The-Mech-Minds/WRO26_Future-Engineers_TMM/others/README.md

# Current robot hardware

The current vehicle uses a Raspberry Pi 5, Raspberry Pi Build HAT, Hiwonder USB camera, LEGO steering and drive motors, and a Force Sensor connected to Build HAT port C. See the [five current vehicle views](../README.md#current-vehicle-photographs) for the actual assembly and [software overview](../README.md#software-structure) for the control flow.

Current robot hardware overview

The diagram shows the control connections documented for this build. The supplied `main.py` confirms the Force Sensor on port C; verify the motor port assignments against the configurable defaults in [`src/vehicle.py`](../src/vehicle.py) before wiring or driving.

The older Raspberry Pi 4B and Arduino pictures have been moved to [`archive/pi4-arduino/`](../archive/pi4-arduino/). They document an earlier prototype.
