The-Mech-Minds/WRO26_Future-Engineers_TMM/models/steering.jpg

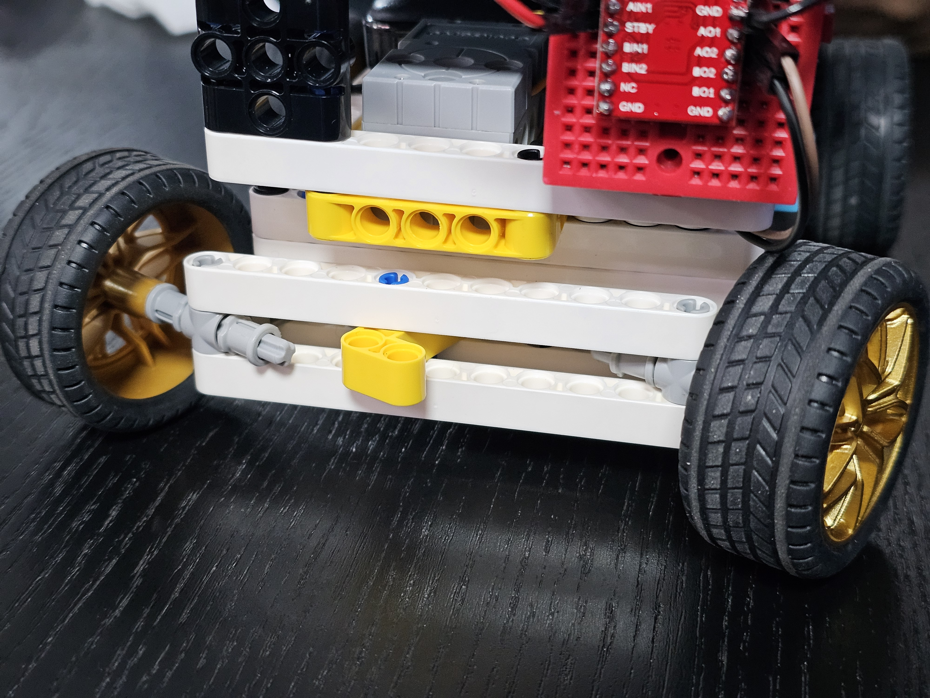
models/steering.jpg
