The-Mech-Minds/WRO26_Future-Engineers_TMM/others/7.4 V Battery Pack.jpg

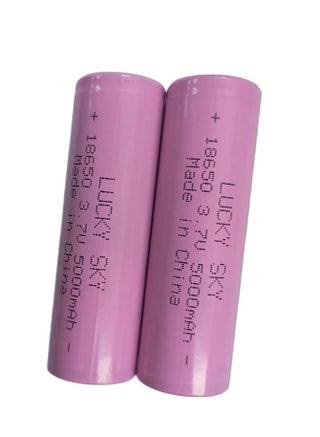
others/7.4 V Battery Pack.jpg
