The-Mech-Minds/WRO26_Future-Engineers_TMM/others/Arduino Uno.webp

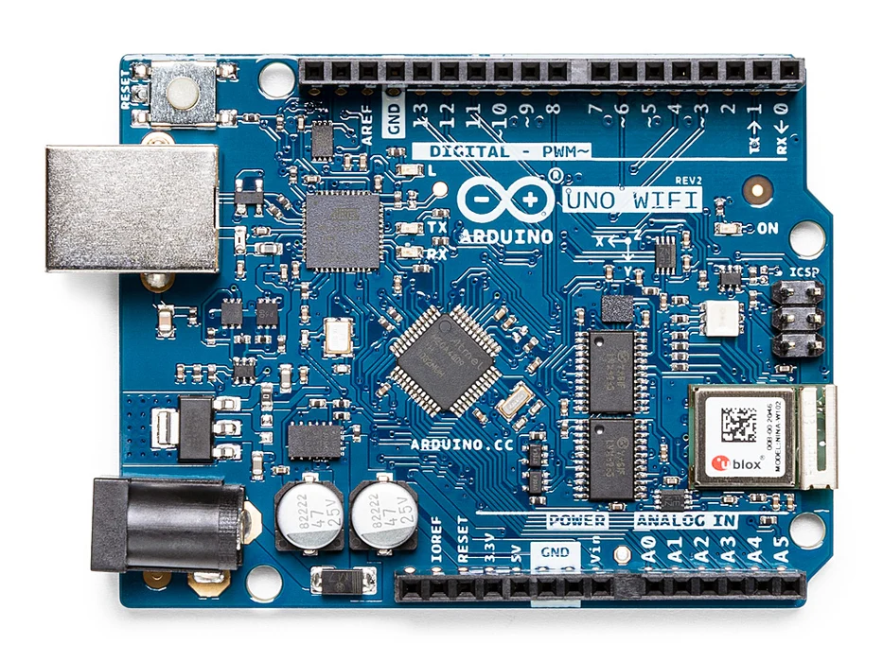
others/Arduino Uno.webp
