The-Mech-Minds/WRO26_Future-Engineers_TMM/others/camera view.jpeg

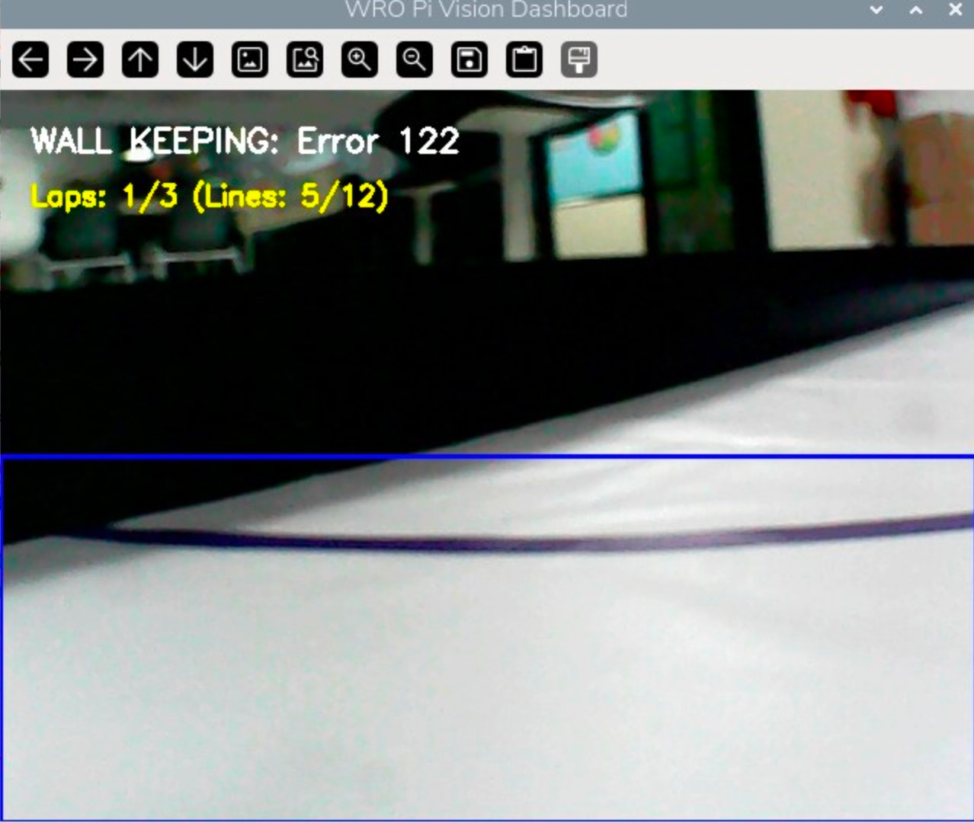
others/camera view.jpeg
