The-Mech-Minds/WRO26_Future-Engineers_TMM/others/Chassis and Drivetrain.jpeg

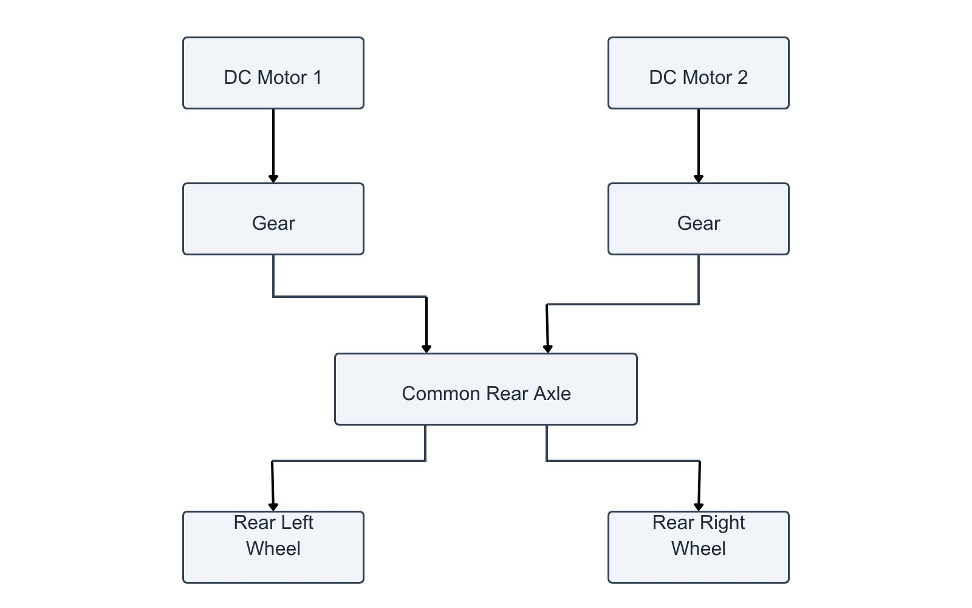
others/Chassis and Drivetrain.jpeg
