The-Mech-Minds/WRO26_Future-Engineers_TMM/others/DC Motors.jpg

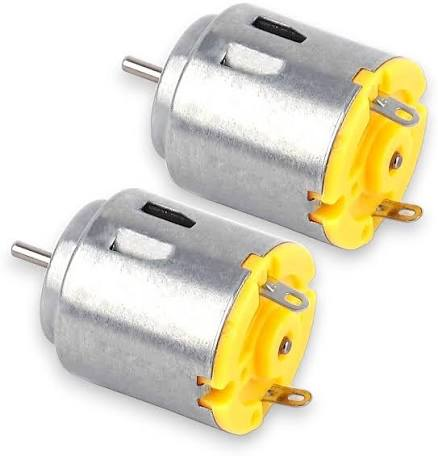
others/DC Motors.jpg
