The-Mech-Minds/WRO26_Future-Engineers_TMM/others/geekservo.webp

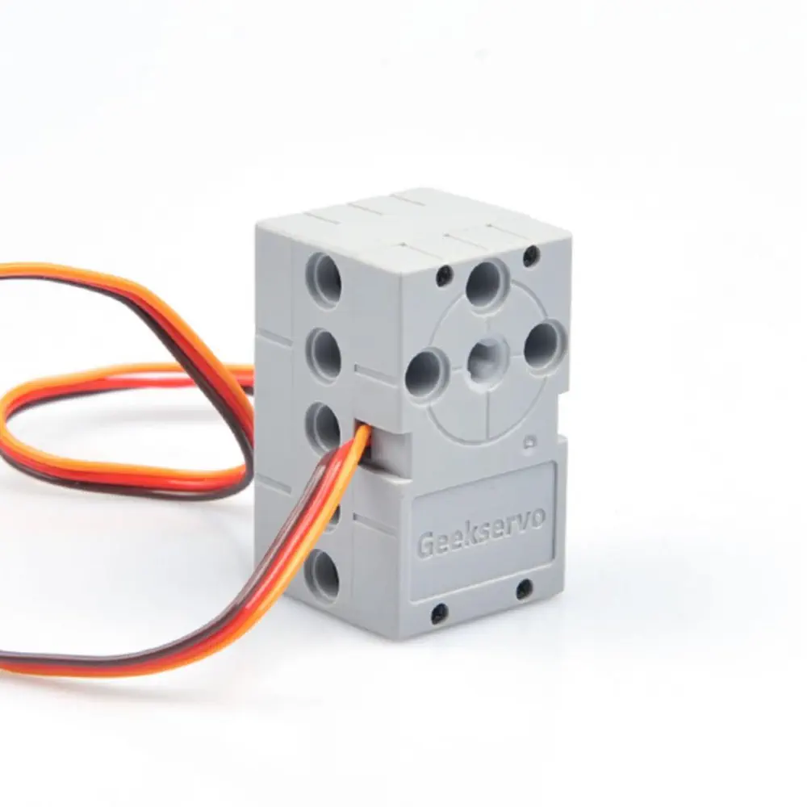
others/geekservo.webp
