The-Mech-Minds/WRO26_Future-Engineers_TMM/others/Motor + Servo.png

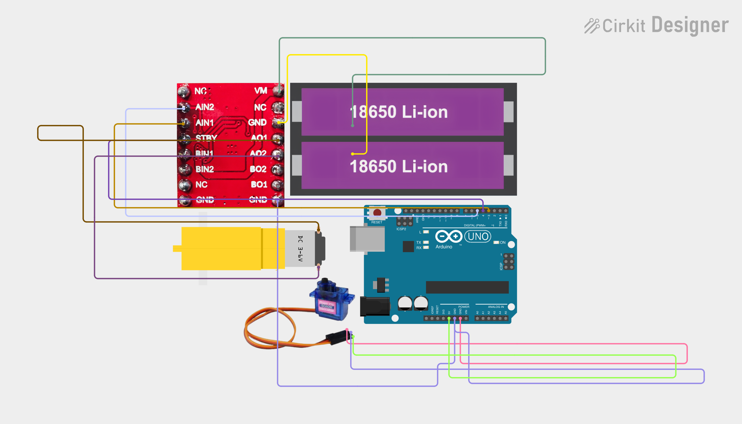
others/Motor + Servo.png
