The-Mech-Minds/WRO26_Future-Engineers_TMM/others/Pi + Arduino.png

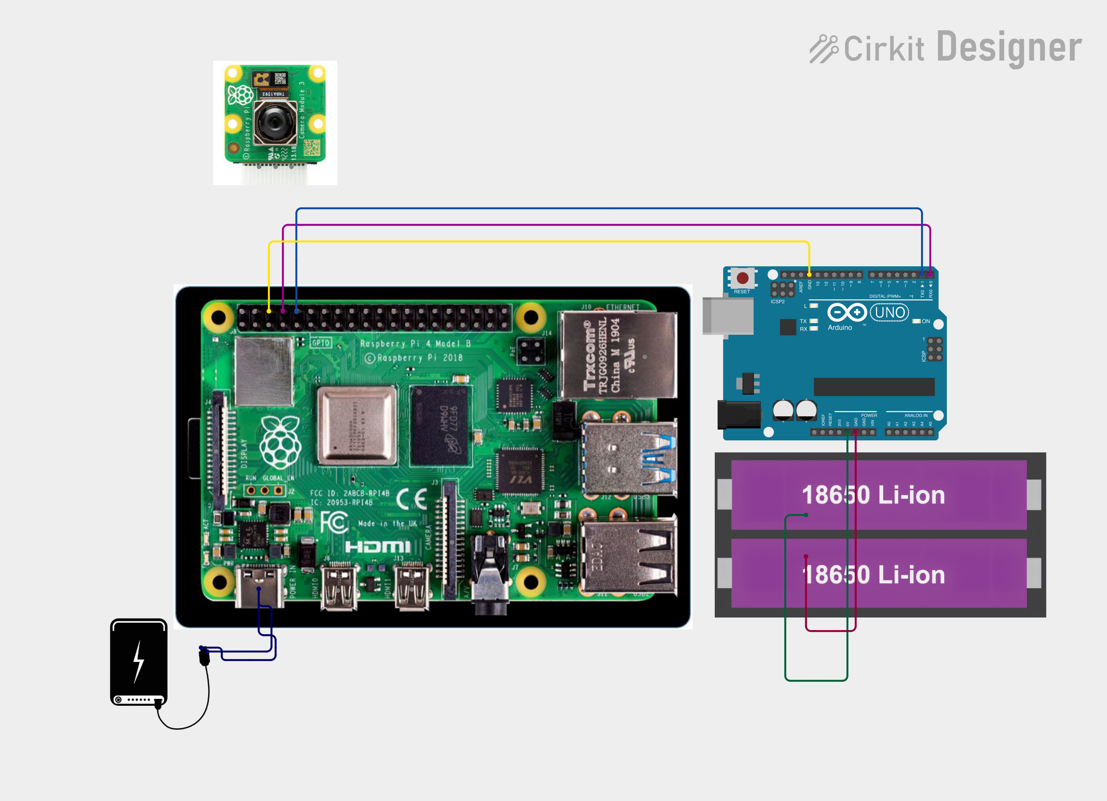
others/Pi + Arduino.png
