The-Mech-Minds/WRO26_Future-Engineers_TMM/others/Power Bank.webp

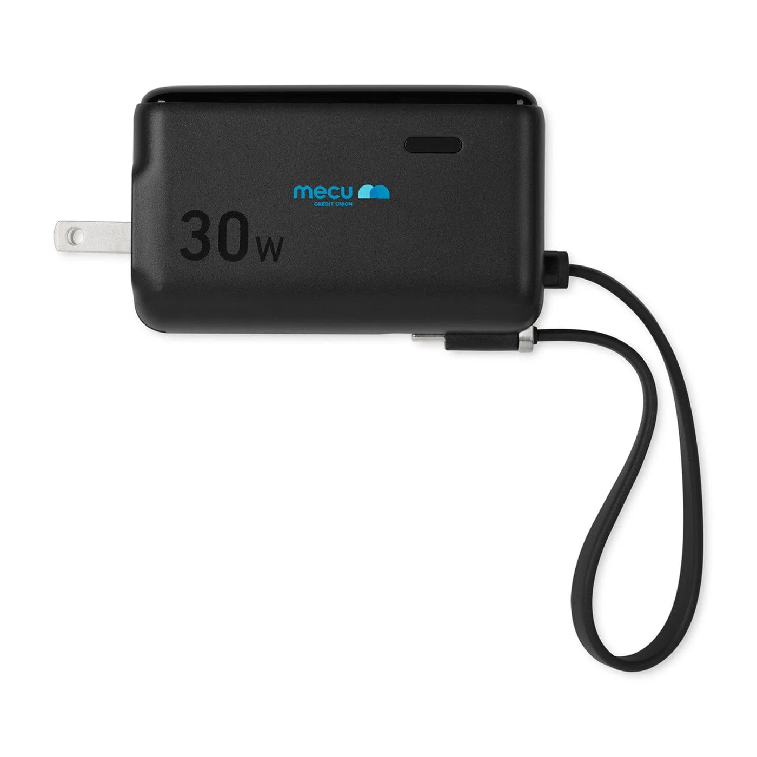
others/Power Bank.webp
