The-Mech-Minds/WRO26_Future-Engineers_TMM/others/power connection.jpeg

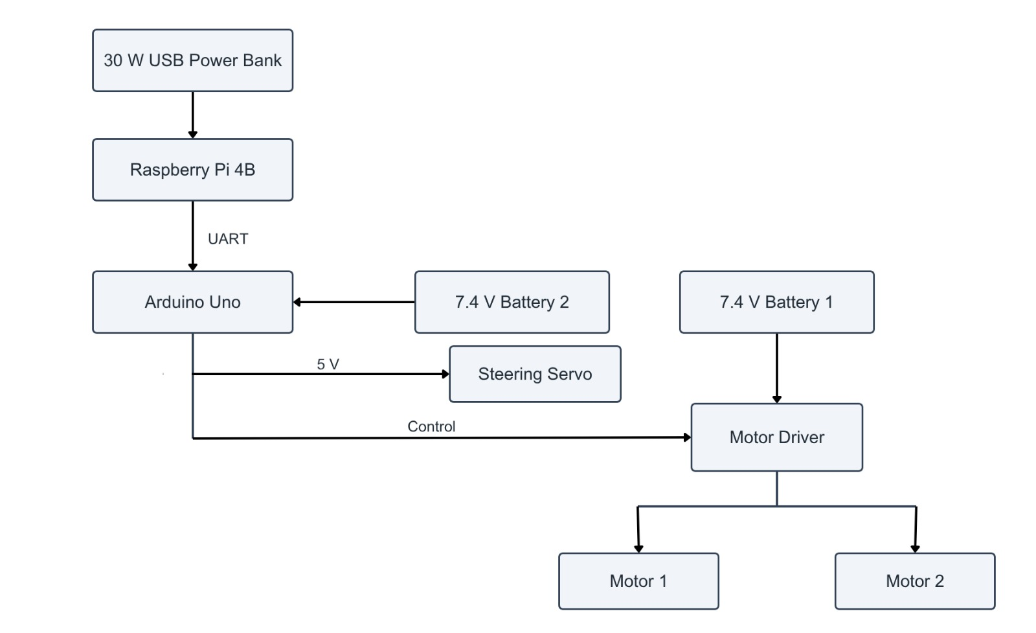
others/power connection.jpeg
