The-Mech-Minds/WRO26_Future-Engineers_TMM/others/Raspberry Pi 4B.webp

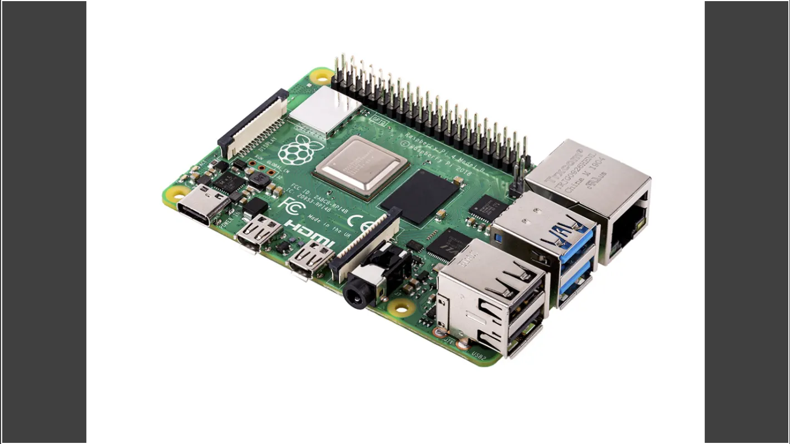
others/Raspberry Pi 4B.webp
