The-Mech-Minds/WRO26_Future-Engineers_TMM/others/Steering Servo.jpeg

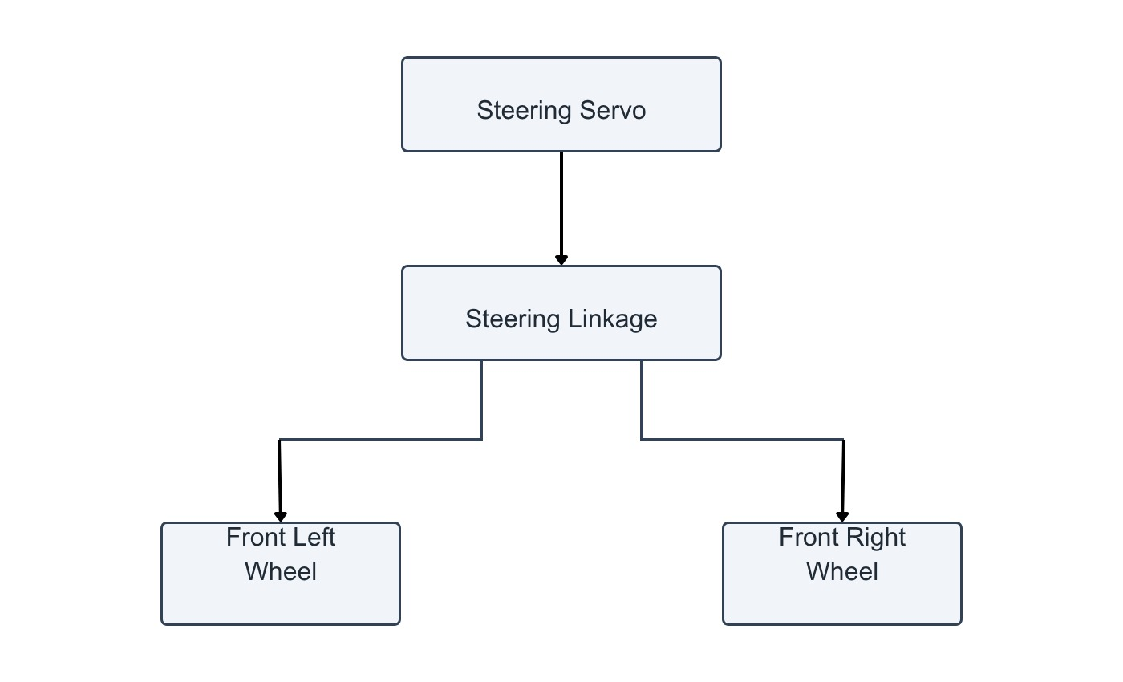
others/Steering Servo.jpeg
