The-Mech-Minds/WRO26_Future-Engineers_TMM/others/System Data Flow Diagram.jpeg

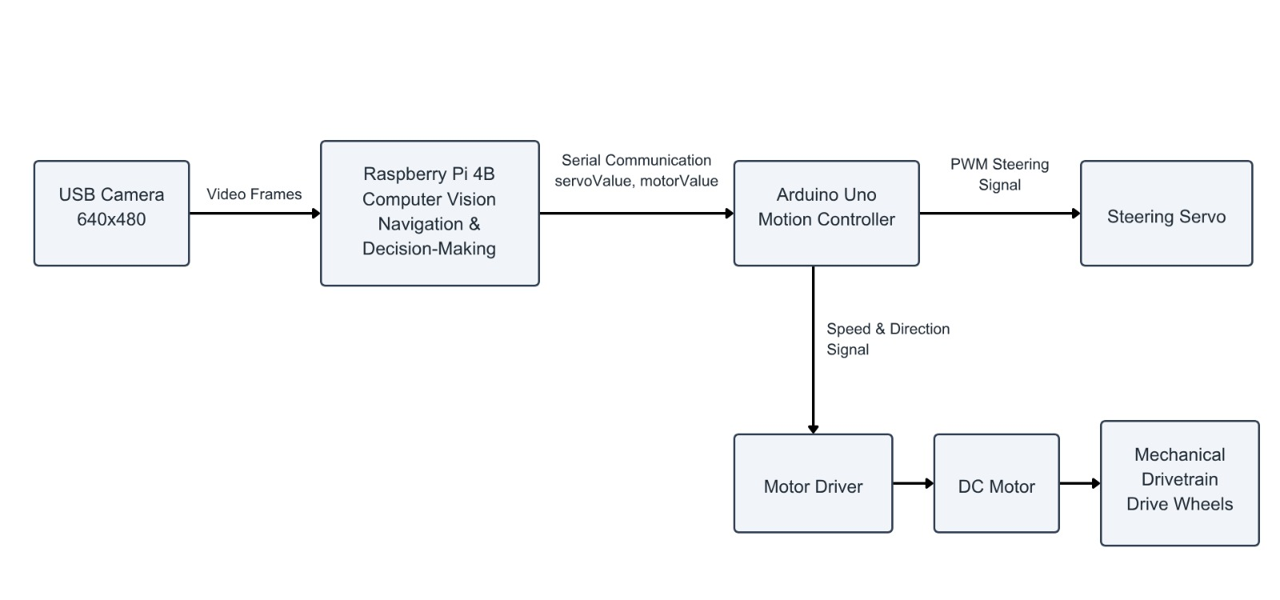
others/System Data Flow Diagram.jpeg
