The-Mech-Minds/WRO26_Future-Engineers_TMM/others/TB6612-type Dual DC Motor Driver.webp

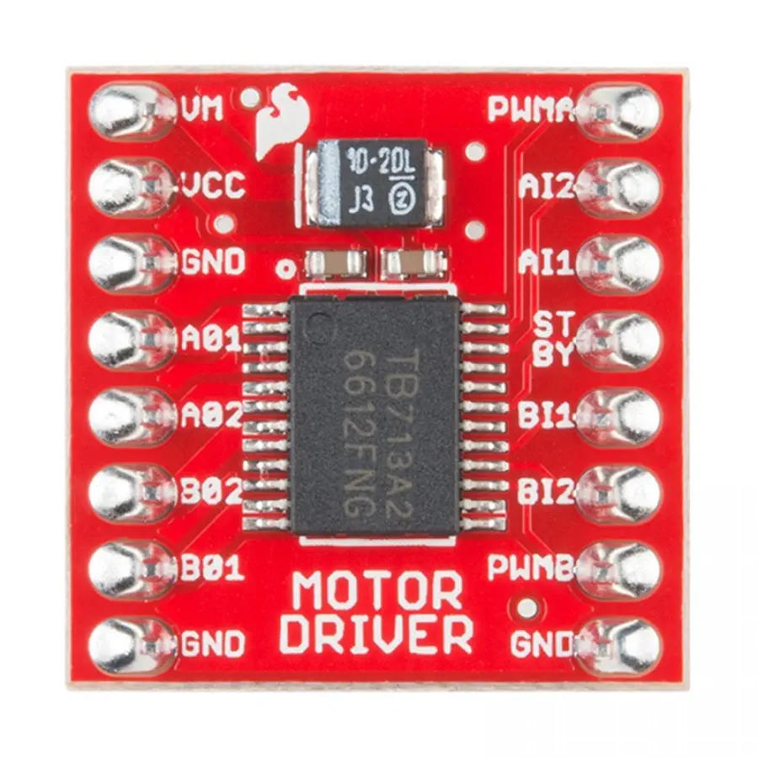
others/TB6612-type Dual DC Motor Driver.webp
