The-Mech-Minds/WRO26_Future-Engineers_TMM/others/USB Camera.jpg

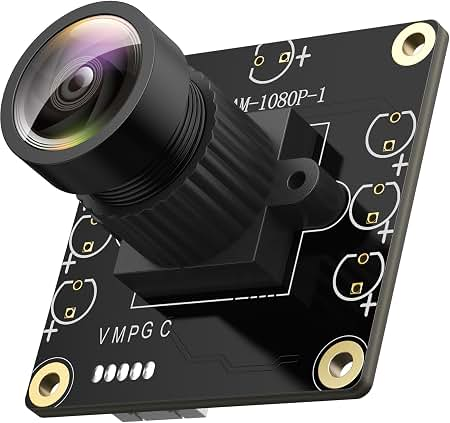
others/USB Camera.jpg
