The-Mech-Minds/WRO26_Future-Engineers_TMM/schemes/WhatsApp Image 2026-09-13 at 10.19.12.jpeg

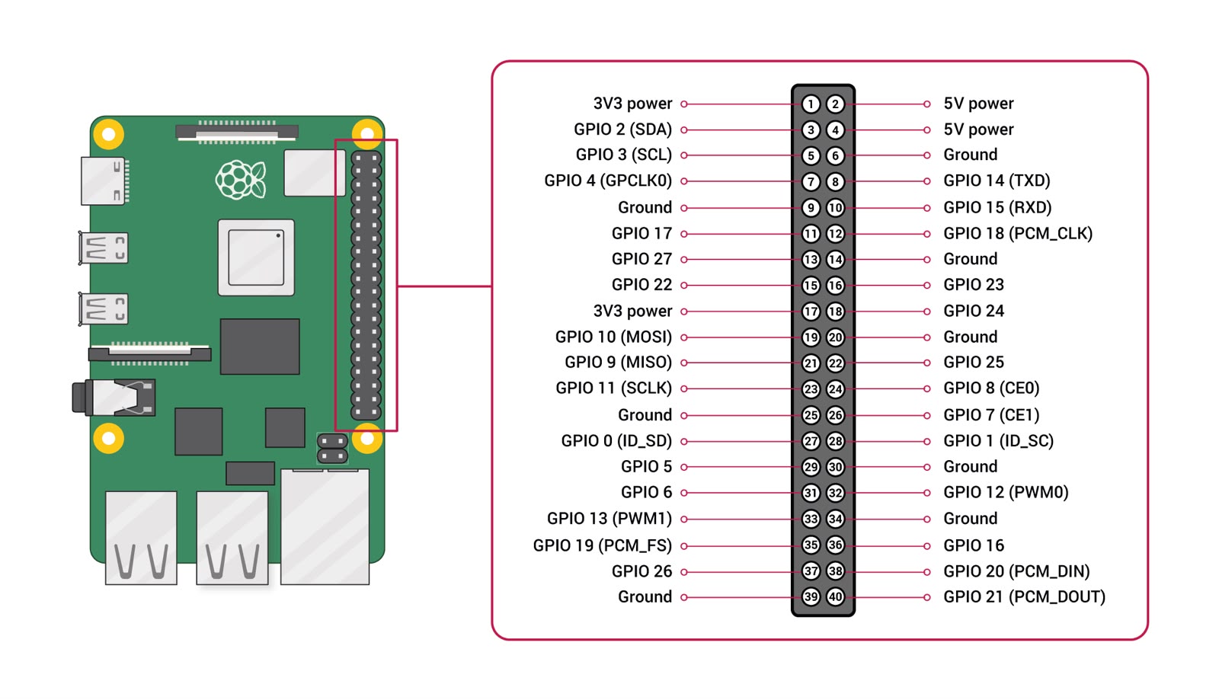
schemes/WhatsApp Image 2026-09-13 at 10.19.12.jpeg
