The-Mech-Minds/WRO26_Future-Engineers_TMM/t-photo/team.png

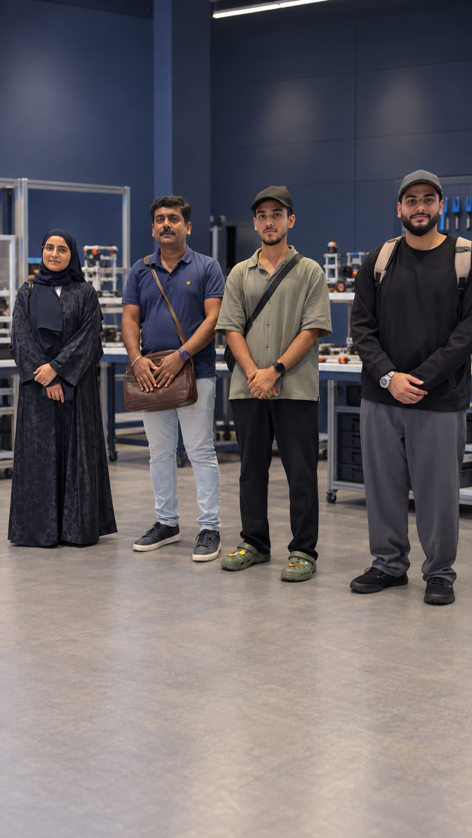
t-photo/team.png
