The-Mech-Minds/WRO26_Future-Engineers_TMM/v-photos/down.jpg

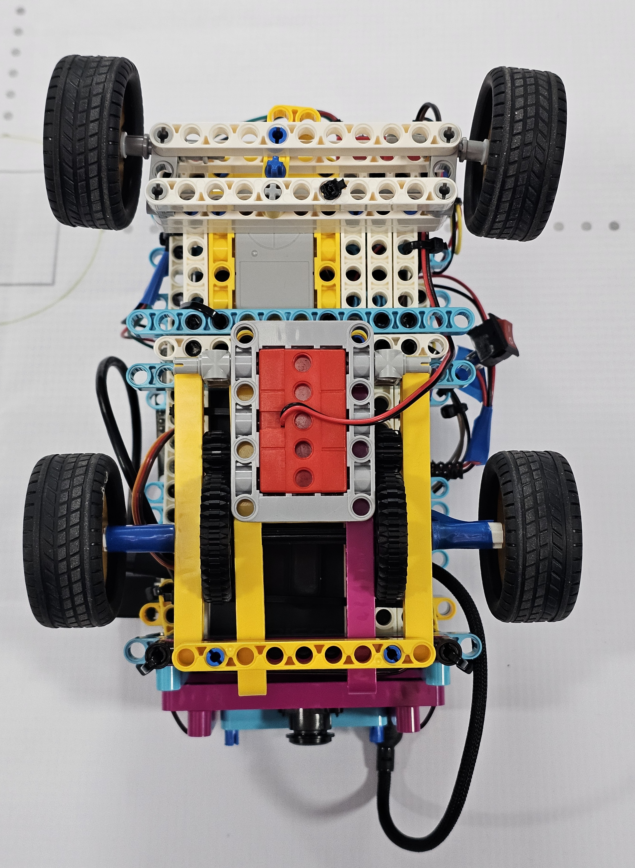
v-photos/down.jpg
