The-Mech-Minds/WRO26_Future-Engineers_TMM/(commit log)

2026-09-09 Create Schematics
2026-09-24 Clarify current Build HAT prototype and link project site
2026-09-24 Document current Pi 5 navigation and vision
2026-09-24 Add current Build HAT main program
2026-09-24 Add current camera vision and lap counting program
2026-09-24 Add exact camera ROI diagram
2026-09-24 Add camera direction lock diagram
2026-09-24 Link current code and add accurate vision diagrams
2026-09-24 Move current main program into src
2026-09-24 Move current vision program into src
2026-09-24 Point documentation to current programs in src
2026-09-24 Add annotated track test screenshots
2026-09-24 Place track test screenshots with vision and wall documentation
2026-09-24 Document Pi 5 robot with current photos and hardware overview
2026-09-24 Add Build HAT vehicle controller with configurable motor calibration
2026-09-24 Document vehicle calibration and archive obsolete model files
2026-09-24 Document evolution from Pi 4B Arduino prototype to Pi 5 Build HAT
